liveboxandy/ZX-Spectrum-Issue-1-32K-RAM-PCB/Images/canvas.png

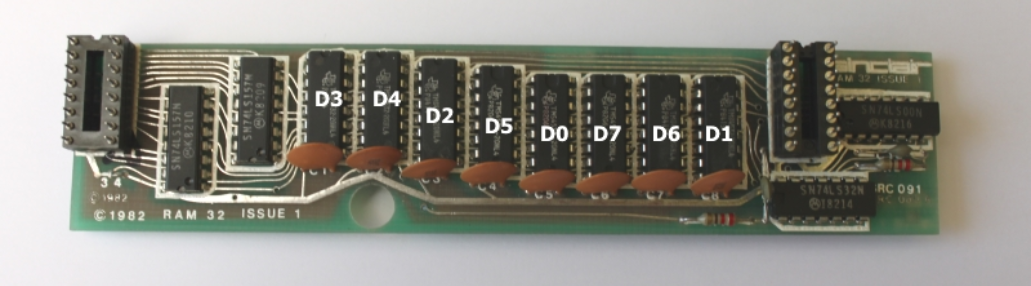
Images/canvas.png
