liveboxandy/ZX-Spectrum-Issue-1-32K-RAM-PCB/Images/RAM32 topside 600dpi mono.jpg

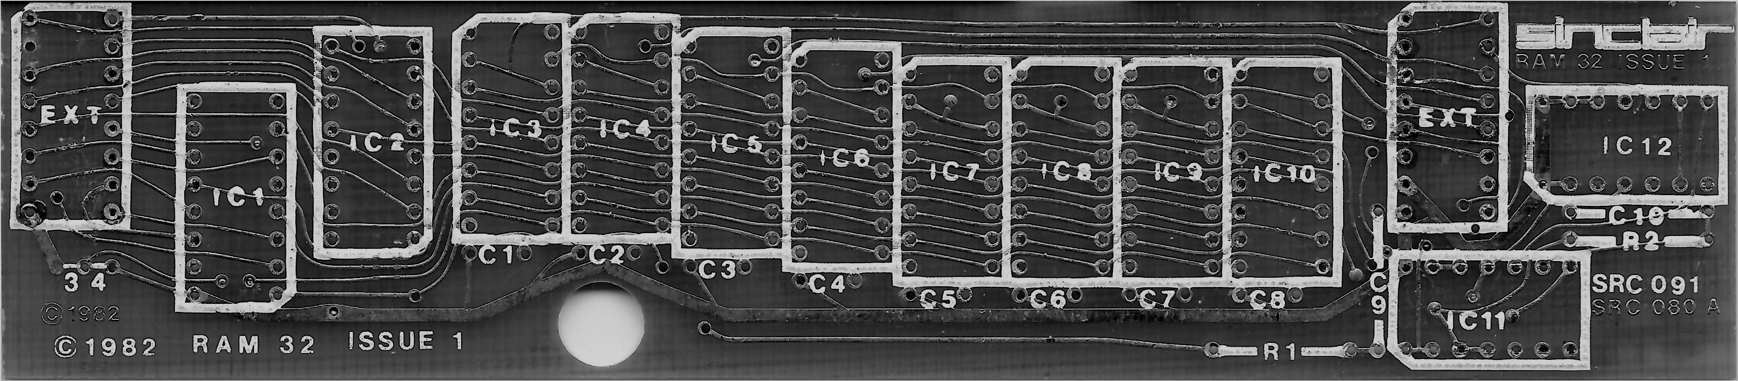
Images/RAM32 topside 600dpi mono.jpg
