liveboxandy/ZX-Spectrum-Issue-1-32K-RAM-PCB/Images/RAM32 underside 600dpi mono reversed.jpg

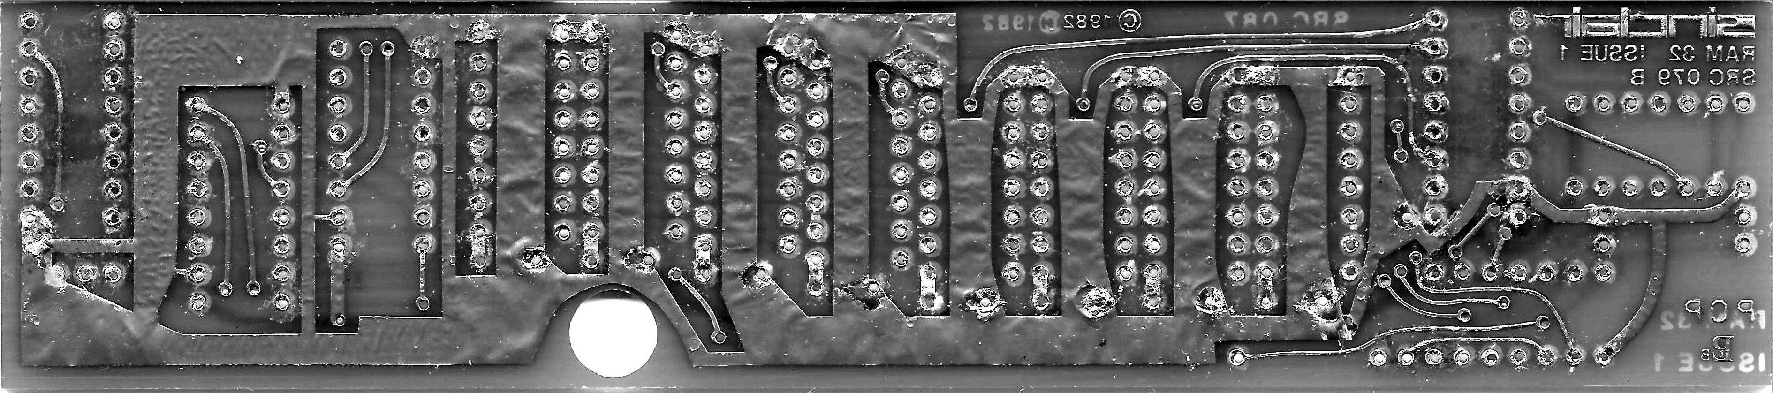
Images/RAM32 underside 600dpi mono reversed.jpg
