liveboxandy/ZX-Spectrum-Issue-1-32K-RAM-PCB/Issue1.csv

Reference | Qty | Value | DNP | Exclude from BOM | Exclude from Board | Footprint | Datasheet
3-4 | 1 | 3 4 |  |  |  | Connector_PinSocket_2.54mm:PinSocket_1x03_P2.54mm_Vertical
C1,C2,C3,C4,C5,C6,C7,C8 | 8 | 47nF |  |  |  | Capacitor_THT:C_Disc_D4.7mm_W2.5mm_P5.00mm
C9 | 1 | 100pF |  |  |  | MOD:C_Axial_L7.8mm_D2.4mm_P12.70mm_Horizontal | https://www.vishay.com/doc?45164
C10 | 1 | 47pF |  |  |  | MOD:C_Axial_L7.8mm_D2.4mm_P12.70mm_Horizontal | https://www.vishay.com/doc?45164
EXT1 | 1 | LHS |  |  |  | MOD:DIP-16_W7.62mm_Socket
EXT2 | 1 | RHS |  |  |  | MOD:DIP-16_W7.62mm_Socket
IC1,IC2 | 2 | 74LS157 |  |  |  | Package_DIP:DIP-16_W7.62mm
IC3,IC4,IC5,IC6,IC7,IC8,IC9,IC10 | 8 | 4532 |  |  |  | Package_DIP:DIP-16_W7.62mm
IC11 | 1 | 74LS32 |  |  |  | Package_DIP:DIP-14_W7.62mm
IC12 | 1 | 74LS00 |  |  |  | Package_DIP:DIP-14_W7.62mm
R1,R2 | 2 | 220R |  |  |  | MOD:R_Axial_L7.8mm_D2.4mm_P12.7mm_Horizontal
