liveboxandy/ZX-Spectrum-Issue-1-32K-RAM-PCB/Issue1 32K RAM.step

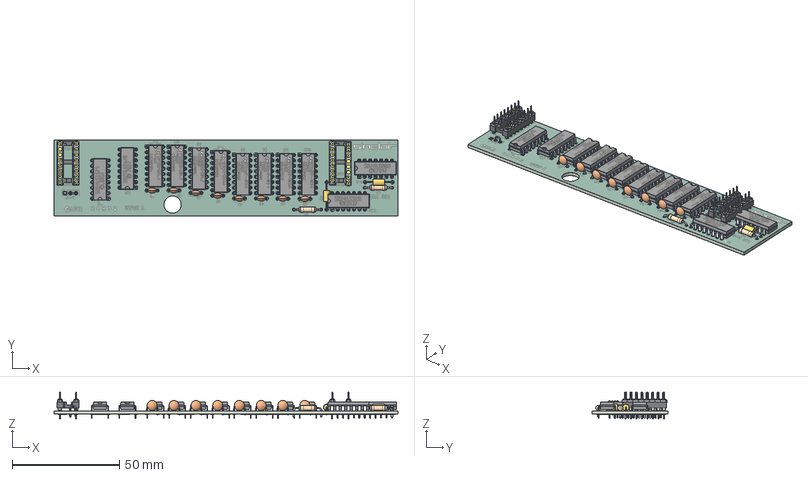
[picture p8: CAD file, 2026-10-26]
Issue1 32K RAM.step
160.0 x 35.6 x 12.5 mm
C_Disc_D47mm_W25mm_P500mm x 8
Basic - DIP 7.62 v2 x 2
DIP Pin 14-20 v2 x 2
R_Axial_DIN0207_L63mm_D25mm_P1016mm_Horizontal x 2
Basic - DIP 7.62 v3 x 10
DIP Pin 14-20 v3 x 10
DIP Pin 14-20 v3(Mirror) x 10
DIP_16_W762mm_Socket x 2
BBL-108-G-E_pins x 32
BBL-108-G-E_socket x 4
C_Axial_L51mm_D31mm_P1250mm_Horizontal x 2
Iss56DC_copper
Iss56DC_pad
Iss56DC_via
Iss56DC_silkscreen
Iss56DC_soldermask x 2
Iss56DC_PCB
