liveboxandy/ZX-Spectrum-Issue-1-32K-RAM-PCB/STP/Link2.54.stp

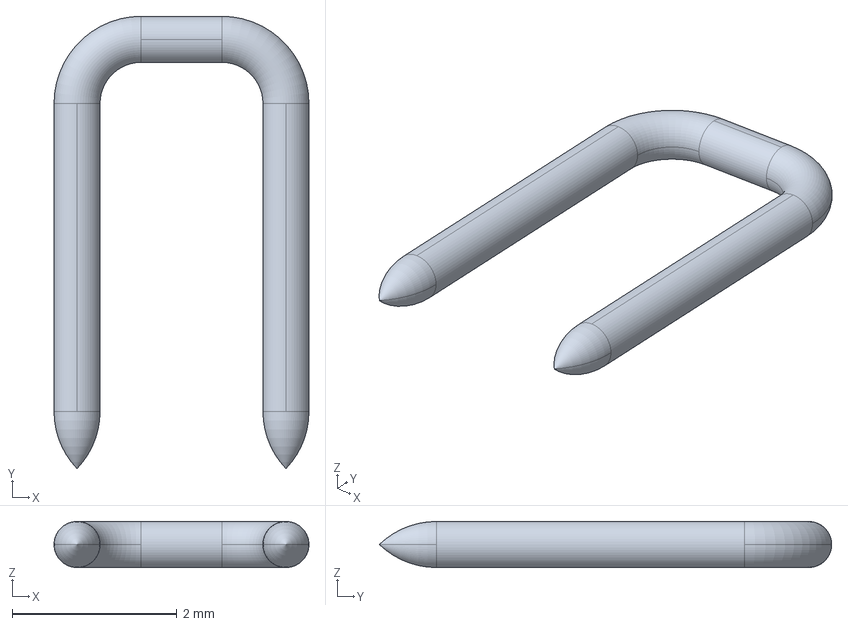
[picture p9: CAD file, 2026-10-26]
STP/Link2.54.stp
3.10 x 5.50 x 0.56 mm
