liveboxandy/ZX-Spectrum-Issue-1-32K-RAM-PCB/STP/DIP-16_W7.62mm_Socket.step

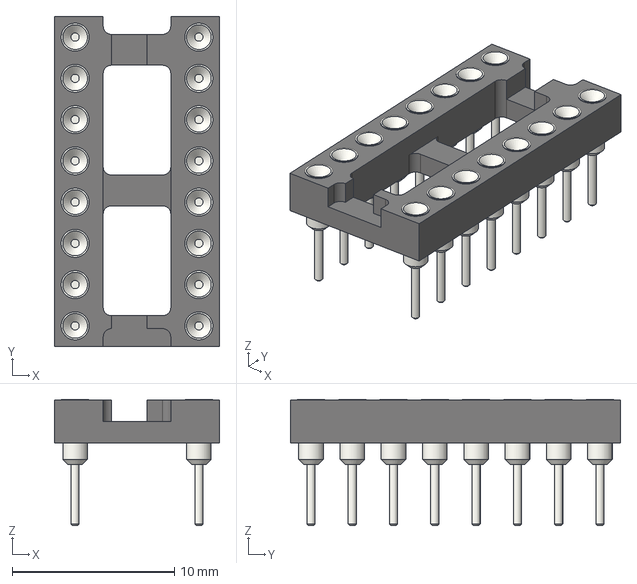
[picture p11: CAD file, 2026-10-23]
STP/DIP-16_W7.62mm_Socket.step
10.2 x 20.3 x 7.79 mm
