liveboxandy/ZX-Spectrum-Issue-1-32K-RAM-PCB/STP/BBL-108-G-E.step

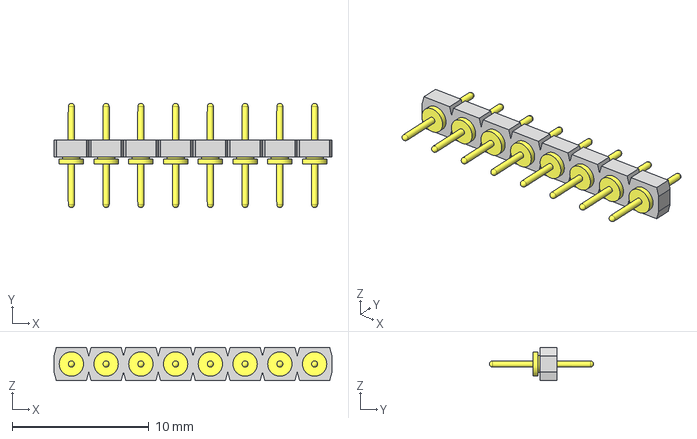
[picture p12: CAD file, 2026-10-23]
STP/BBL-108-G-E.step
20.3 x 7.62 x 2.44 mm
BBL-108-G-E_pins x 8
BBL-108-G-E_socket
