liveboxandy/ZX-Spectrum-Issue-1-32K-RAM-PCB/(list of files, cad)

Other CAD files:
STP/MOT_SN74LS00N.step
STP/MOT_SN74LS157N.step
STP/MOT_SN74LS32N.step
