liveboxandy/ZX-Spectrum-Issue-1-32K-RAM-PCB/Issue1.pdf

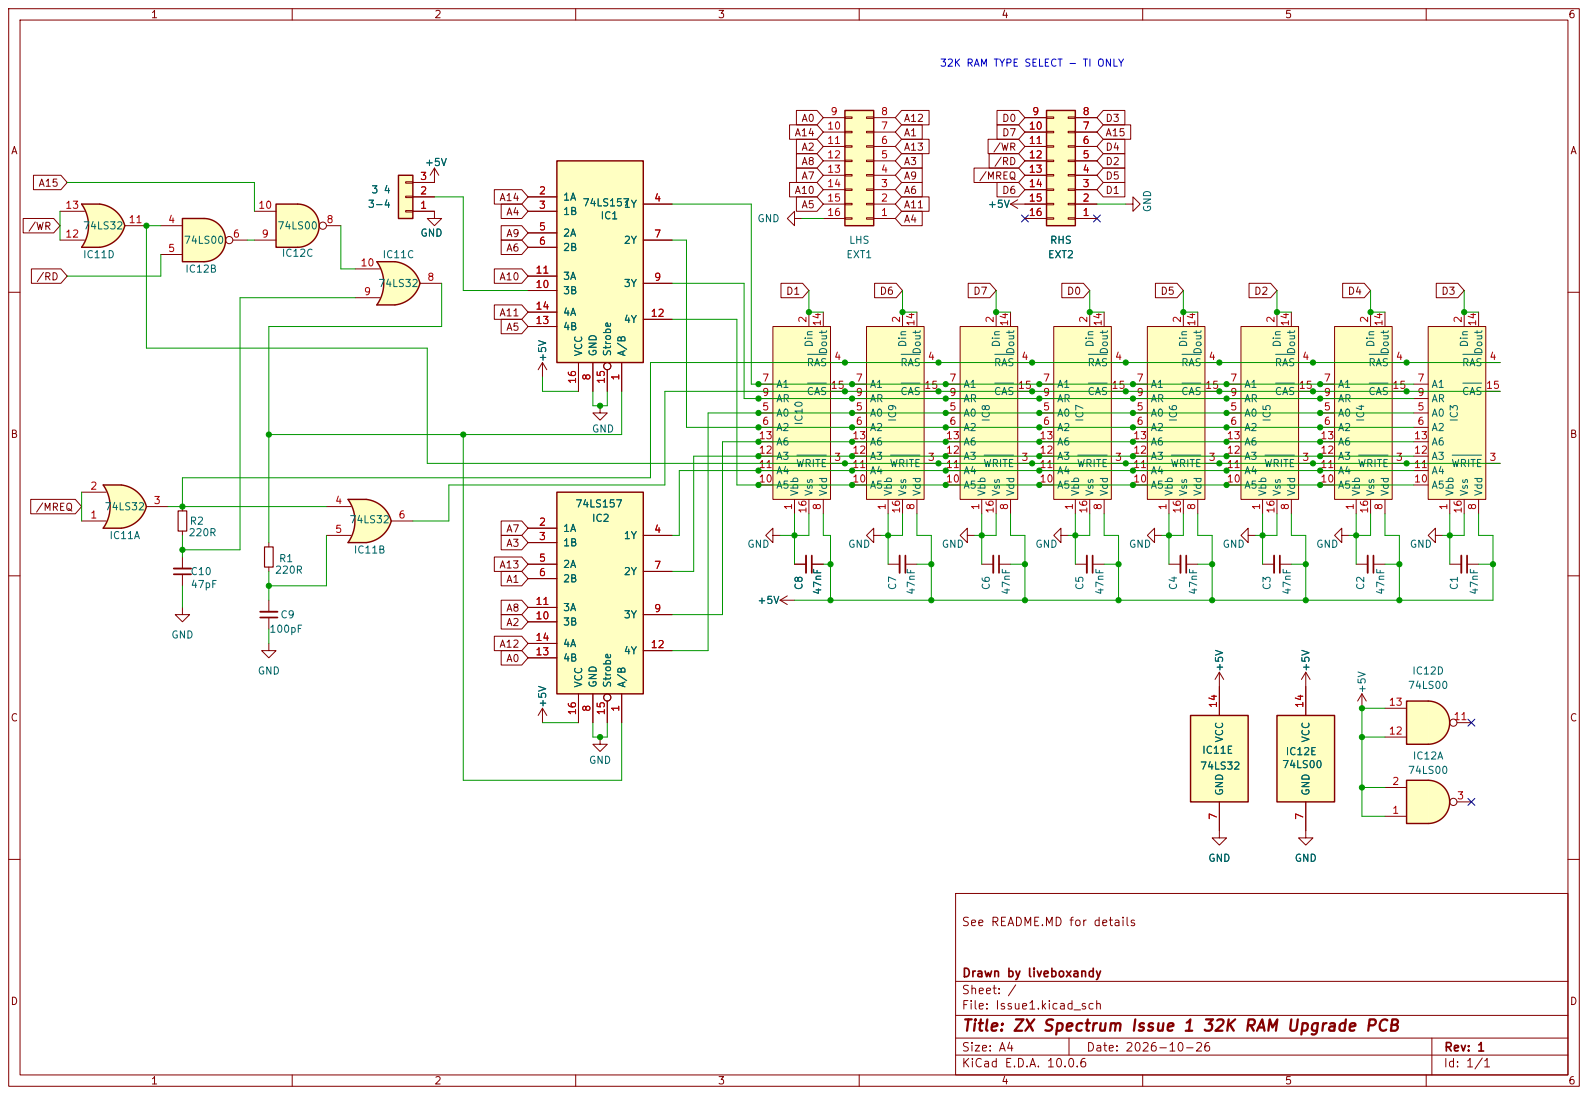
[picture p13: page 1]

Drawn by liveboxandy
Sheet: /
File: Issue1.kicad_sch
Title: ZX Spectrum Issue 1 32K RAM Upgrade PCB

Size: A4 | Rev: 1
KiCad E.D.A. 10.0.6 | Id: 1/1
