liveboxandy/ZX-Spectrum-Issue-1-32K-RAM-PCB/Issue1.kicad_pcb

## KiCad design Issue1.kicad_pcb (2026-10-26)

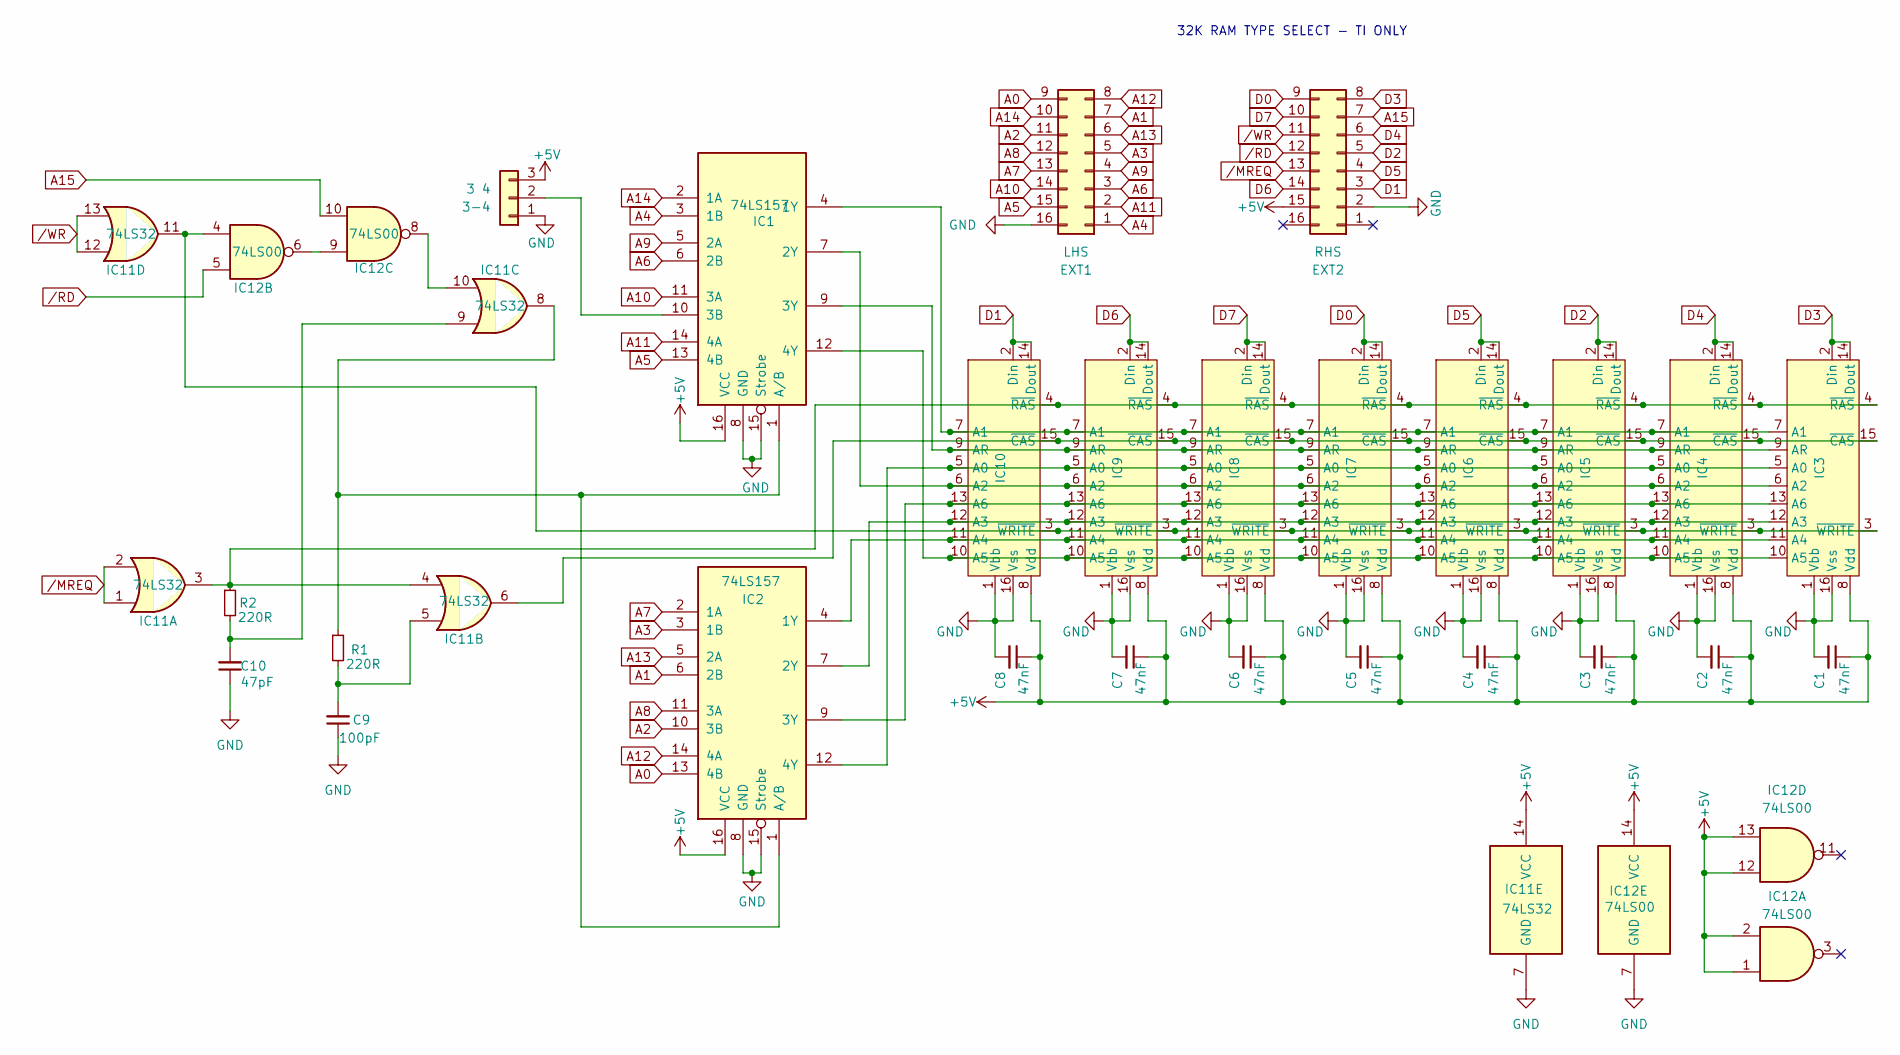
[picture p14: schematic Issue1.kicad_sch, ZX Spectrum Issue 1 32K RAM Upgrade PCB]

Parts:
3-4: 3 4; PinSocket_1x03_P2.54mm_Vertical
C1, C2, C3, C4, C5, C6, C7, C8: 47nF; C_Disc_D4.7mm_W2.5mm_P5.00mm
C9: 100pF; C_Axial_L7.8mm_D2.4mm_P12.70mm_Horizontal
C10: 47pF; C_Axial_L7.8mm_D2.4mm_P12.70mm_Horizontal
EXT1: LHS; DIP-16_W7.62mm_Socket
EXT2: RHS; DIP-16_W7.62mm_Socket
IC1, IC2: 74LS157; DIP-16_W7.62mm
IC3, IC4, IC5, IC6, IC7, IC8, IC9, IC10: 4532; DIP-16_W7.62mm
IC11: 74LS32; DIP-14_W7.62mm
IC12: 74LS00; DIP-14_W7.62mm
R1, R2: 220R; R_Axial_L7.8mm_D2.4mm_P12.7mm_Horizontal

Connections:
+5V: 3-4.3, C1.1, C2.1, C3.1, C4.1, C5.1, C6.1, C7.1, C8.1, EXT2.15, IC1.16 (VCC), IC2.16 (VCC), IC3.8 (Vdd), IC4.8 (Vdd), IC5.8 (Vdd), IC6.8 (Vdd), IC7.8 (Vdd), IC8.8 (Vdd), IC9.8 (Vdd), IC10.8 (Vdd), IC11.14 (VCC), IC12.1, IC12.2, IC12.12, IC12.13, IC12.14 (VCC)
A0: EXT1.9, IC2.13 (4B)
A1: EXT1.7, IC2.6 (2B)
A2: EXT1.11, IC2.10 (3B)
A3: EXT1.5, IC2.3 (1B)
A4: EXT1.1, IC1.3 (1B)
A5: EXT1.15, IC1.13 (4B)
A6: EXT1.3, IC1.6 (2B)
A7: EXT1.13, IC2.2 (1A)
A8: EXT1.12, IC2.11 (3A)
A9: EXT1.4, IC1.5 (2A)
A10: EXT1.14, IC1.11 (3A)
A11: EXT1.2, IC1.14 (4A)
A12: EXT1.8, IC2.14 (4A)
A13: EXT1.6, IC2.5 (2A)
A14: EXT1.10, IC1.2 (1A)
A15: EXT2.7, IC12.10
D0: EXT2.9, IC7.2 (Din), IC7.14 (Dout)
D1: EXT2.3, IC10.2 (Din), IC10.14 (Dout)
D2: EXT2.5, IC5.2 (Din), IC5.14 (Dout)
D3: EXT2.8, IC3.2 (Din), IC3.14 (Dout)
D4: EXT2.6, IC4.2 (Din), IC4.14 (Dout)
D5: EXT2.4, IC6.2 (Din), IC6.14 (Dout)
D6: EXT2.14, IC9.2 (Din), IC9.14 (Dout)
D7: EXT2.10, IC8.2 (Din), IC8.14 (Dout)
GND: 3-4.1, C1.2, C2.2, C3.2, C4.2, C5.2, C6.2, C7.2, C8.2, C9.1, C10.1, EXT1.16, EXT2.2, IC1.8 (GND), IC1.15 (Strobe), IC2.8 (GND), IC2.15 (Strobe), IC3.1 (Vbb), IC3.16 (Vss), IC4.1 (Vbb), IC4.16 (Vss), IC5.1 (Vbb), IC5.16 (Vss), IC6.1 (Vbb), IC6.16 (Vss), IC7.1 (Vbb), IC7.16 (Vss), IC8.1 (Vbb), IC8.16 (Vss), IC9.1 (Vbb), IC9.16 (Vss), IC10.1 (Vbb), IC10.16 (Vss), IC11.7 (GND), IC12.7 (GND)
unnamed: 3-4.2, IC1.10 (3B)
unnamed: C9.2, IC11.5, R1.2
unnamed: C10.2, IC11.9, R2.2
unnamed: IC1.4 (1Y), IC3.7 (A1), IC4.7 (A1), IC5.7 (A1), IC6.7 (A1), IC7.7 (A1), IC8.7 (A1), IC9.7 (A1), IC10.7 (A1)
unnamed: IC1.7 (2Y), IC3.6 (A2), IC4.6 (A2), IC5.6 (A2), IC6.6 (A2), IC7.6 (A2), IC8.6 (A2), IC9.6 (A2), IC10.6 (A2)
unnamed: IC1.9 (3Y), IC3.9 (AR), IC4.9 (AR), IC5.9 (AR), IC6.9 (AR), IC7.9 (AR), IC8.9 (AR), IC9.9 (AR), IC10.9 (AR)
unnamed: IC1.12 (4Y), IC3.10 (A5), IC4.10 (A5), IC5.10 (A5), IC6.10 (A5), IC7.10 (A5), IC8.10 (A5), IC9.10 (A5), IC10.10 (A5)
unnamed: IC1.1 (A/B), IC2.1 (A/B), IC11.8, R1.1
unnamed: IC2.12 (4Y), IC3.5 (A0), IC4.5 (A0), IC5.5 (A0), IC6.5 (A0), IC7.5 (A0), IC8.5 (A0), IC9.5 (A0), IC10.5 (A0)
unnamed: IC2.7 (2Y), IC3.12 (A3), IC4.12 (A3), IC5.12 (A3), IC6.12 (A3), IC7.12 (A3), IC8.12 (A3), IC9.12 (A3), IC10.12 (A3)
unnamed: IC2.4 (1Y), IC3.11 (A4), IC4.11 (A4), IC5.11 (A4), IC6.11 (A4), IC7.11 (A4), IC8.11 (A4), IC9.11 (A4), IC10.11 (A4)
unnamed: IC2.9 (3Y), IC3.13 (A6), IC4.13 (A6), IC5.13 (A6), IC6.13 (A6), IC7.13 (A6), IC8.13 (A6), IC9.13 (A6), IC10.13 (A6)
unnamed: IC3.15 (~CAS), IC4.15 (~CAS), IC5.15 (~CAS), IC6.15 (~CAS), IC7.15 (~CAS), IC8.15 (~CAS), IC9.15 (~CAS), IC10.15 (~CAS), IC11.6
unnamed: IC3.4 (~RAS), IC4.4 (~RAS), IC5.4 (~RAS), IC6.4 (~RAS), IC7.4 (~RAS), IC8.4 (~RAS), IC9.4 (~RAS), IC10.4 (~RAS), IC11.3, IC11.4, R2.1
unnamed: IC3.3 (~WRITE), IC4.3 (~WRITE), IC5.3 (~WRITE), IC6.3 (~WRITE), IC7.3 (~WRITE), IC8.3 (~WRITE), IC9.3 (~WRITE), IC10.3 (~WRITE), IC11.11, IC12.4
unnamed: IC11.10, IC12.8
unnamed: IC12.6, IC12.9
/MREQ: EXT2.13, IC11.1, IC11.2
/RD: EXT2.12, IC12.5

Notes on the sheet:
32K RAM TYPE SELECT - TI ONLY

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
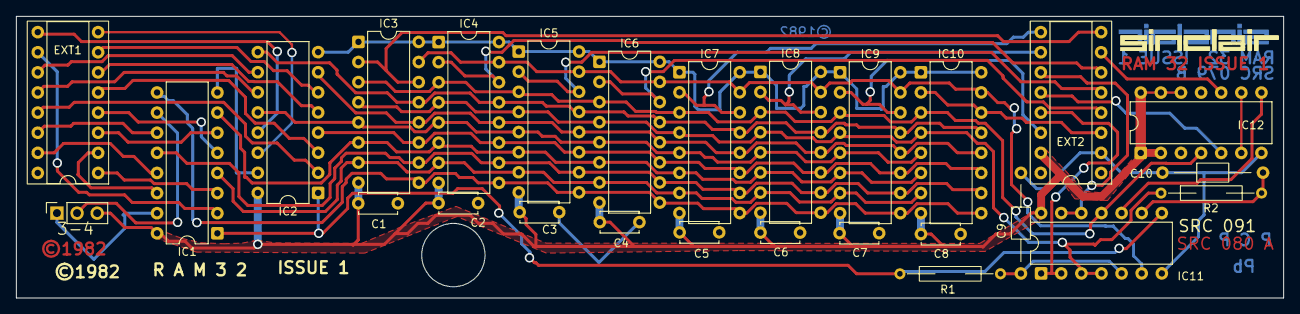
[picture p15: board Issue1.kicad_pcb from above]

Board: 2 copper layers, 160.0 x 35.6 mm, 27 parts (0 on the bottom side), 46 nets.
