liveboxandy/ZX-Spectrum-Issue-1-32K-RAM-PCB/ZX Spectrum 48K Issue 1 32K RAM Pinout.txt

16Pin LHS Issue1 TopSide EXT1
1 Gnd		16 A4
2 A5		15 A11
3 A10		14 A6
4 A7		13 A9
5 A8		12 A3
6 A2		11 A13
7 A14		10 A1
8 A0		 9 A12

14Pin RHS Issue1 TopSide EXT2
1 VCC		14 Gnd
2 ROM18-D6	13 ROM12-D1
3 /MREQ		12 ROM15-D5
4 /RD		11 ROM13-D2
5 /WR		10 D4
6 ROM19-D7	 9 A15 D8K
7 ROM10-D0	 8 D3
0 NC		 0NC

16Pin LHS RAM32 TopSide EXT1
9 A0	IC2/13	8 A12	IC2/14
10 A14	IC1/2	7 A1	IC2/6
11 A2	IC2/10	6 A13	IC2/5
12 A8	IC2/11	5 A3	IC2/3
13 A7	IC2/2	4 A9	IC1/5
14 A10	IC1/11	3 A6	IC1/6
15 A5	IC1/13	2 A11	IC1/14
16 Gnd		1 A4	IC1/3

16Pin RHS RAM32 TopSide EXT2
9 D0	IC7/2		8 D3	IC3/2
10 D7	IC8/2		7 A15	IC12/10
11 /WR	IC11/12		6 D4	IC4/2
12 /RD	IC12/5		5 D2	IC5/2
13 /MREQIC11/1-2	4 D5	IC6/2
14 D6	IC9/2		3 D1	IC10/2
15 VCC	IC11/14		2 Gnd	GND
16 NC	???		1 NC	???

IC1/9	IC3/9	IC1/8	GND
IC1/10	3-4/2	IC1/7	IC3/6
IC1/11	EXT1/14	IC1/6	EXT1/6
IC1/12	IC3/10	IC1/5	EXT1/4
IC1/13	EXT1/15	IC1/4	IC3/7	
IC1/14	EXT1/2	IC1/3	EXT1/1
IC1/15	GND	IC1/2	EXT1/10
IC1/16	+5V	IC1/1	IC2/1	IC3/8

IC2/9	IC3/13	IC2/8	GND
IC2/10	EXT1/11	IC2/7	IC3/12
IC2/11	EXT1/12	IC2/6	EXT1/7
IC2/12	IC3/5	IC2/5	EXT1/6
IC2/13	EXT1/9	IC2/4	IC3/11
IC2/14	EXT1/8	IC2/3	EXT1/5
IC2/15	GND	IC2/2	EXT1/13
IC2/16	+5V	IC2/1	IC1/1	IC3/8

IC3/1	GND		IC3/16	GND
IC3/2	IC3/14		IC3/15	
IC3/3	IC4/3		IC3/14	IC3/2	EXT2/8
IC3/4	IC4/4		IC3/13	IC4/13	IC2/9
IC3/5	IC4/5	IC2/12	IC3/12	IC4/12	IC2/7
IC3/6	IC4/6	IC1/7	IC3/11	IC4/11	IC2/4
IC3/7	IC4/7	IC1/4	IC3/10	IC4/10	IC1/12
IC3/8	+5V		IC3/9	IC4/9	IC1/9

IC4-10 AS IC3 BAR 2/14
IC4/2	IC4/14	EXT2/6
IC5/2	IC5-14	EXT2/5
IC6/2	IC6/14	EXT2/4
IC7/2	IC7/14	EXT2/9
IC8/2	IC8/14	EXT2/10
IC9/2	IC9/14	EXT2/14
IC10/2	IC10/14	EXT2/3

IC11/1	IC11/2	EXT2/13		IC11/14	+5V
IC11/2	IC11/1	EXT2/13		IC11/13	IC11/12	EXT2/11
IC11/3	IC11/4	R2/1	IC10/4	IC11/12	IC11/13
IC11/4	IC11/3			IC11/11	IC12/4	IC10/3
IC11/5	R1/2	C9/2		IC11/10 IC12/8
IC11/6	IC10/15			IC11/9	R2/2	C10/2
IC11/7	GND			IC11/8	R1/1	IC1/1	IC2/1

IC12/1	+5V		IC12/14	+5V
IC12/2	+5V		IC12/13	+5V
IC12/3	NC		IC12/12	+5V
IC12/4	IC11/11	IC10/3	IC12/11	NC
IC12/5	EXT2/12		IC12/10	EXT2/7
IC12/6	IC12/9		IC12/9	IC12/6
IC12/7	GND		IC12/8	IC11/10

C10/1	GND
C10/2	R2/2
C9/1	GND
C9/2	R1/2
R1/1	IC2/1	IC1/1
R1/2	C9/2
R2/1	IC11/3	IC10/4
R2/2	C10/2

3-4/1	EXT1/16
3-4/2	IC1/10
3-4/3	IC1/16
