liveboxandy/ZX-Spectrum-Issue-1-32K-RAM-PCB/Images/Issue1Expansion.bmp

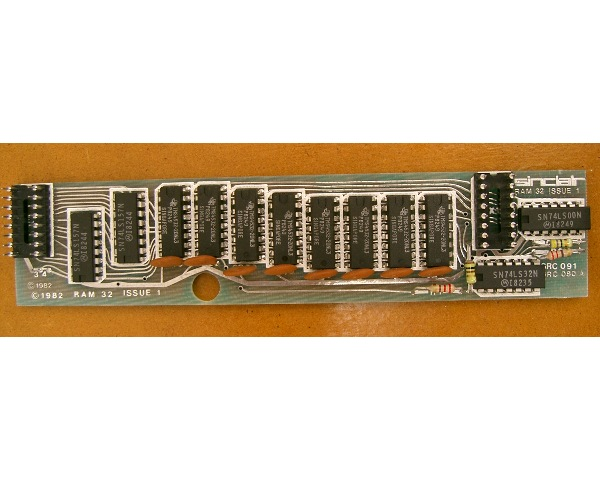
Images/Issue1Expansion.bmp
