liveboxandy/ZX-Spectrum-Issue-1-32K-RAM-PCB/(commit log)

2026-10-23 Initial Release
    Initial Release
    [BBL-108-G-E.step, DIP-16_W7.62mm_Socket.step, Issue1 32K RAM.step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]
2026-10-23 Rename files with spaces
    Rename files with spaces
    [Issue1_32K_RAM.step]
2026-10-26 Correct C9 & C10 Values
    Correct C9 & C10 Values
    [Issue1 32K RAM.step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]
2026-10-26 Deleted unwanted files
    [Issue1_32K_RAM.step]
