liveboxandy/ZX-Spectrum-Issue-1-32K-RAM-PCB/(notices)

Notices in the files:
STP/DIP-16_W7.62mm_Socket.step:
Copyright (C) 2017, Terje Io
This program is free software: you can redistribute it and/or modify
it under the terms of the GNU General Public License as published by
the Free Software Foundation, either version 3 of the License, or
any later version.
itself might be covered by the GNU General Public License.
Issue1.kicad_pcb:
©1982
STP/BBL-108-G-E.step:
author */ ('License CC BY-ND 4.0'),
